jeffkub/esp32-energy-monitor/hardware/energy_monitor/energy_monitor.pdf

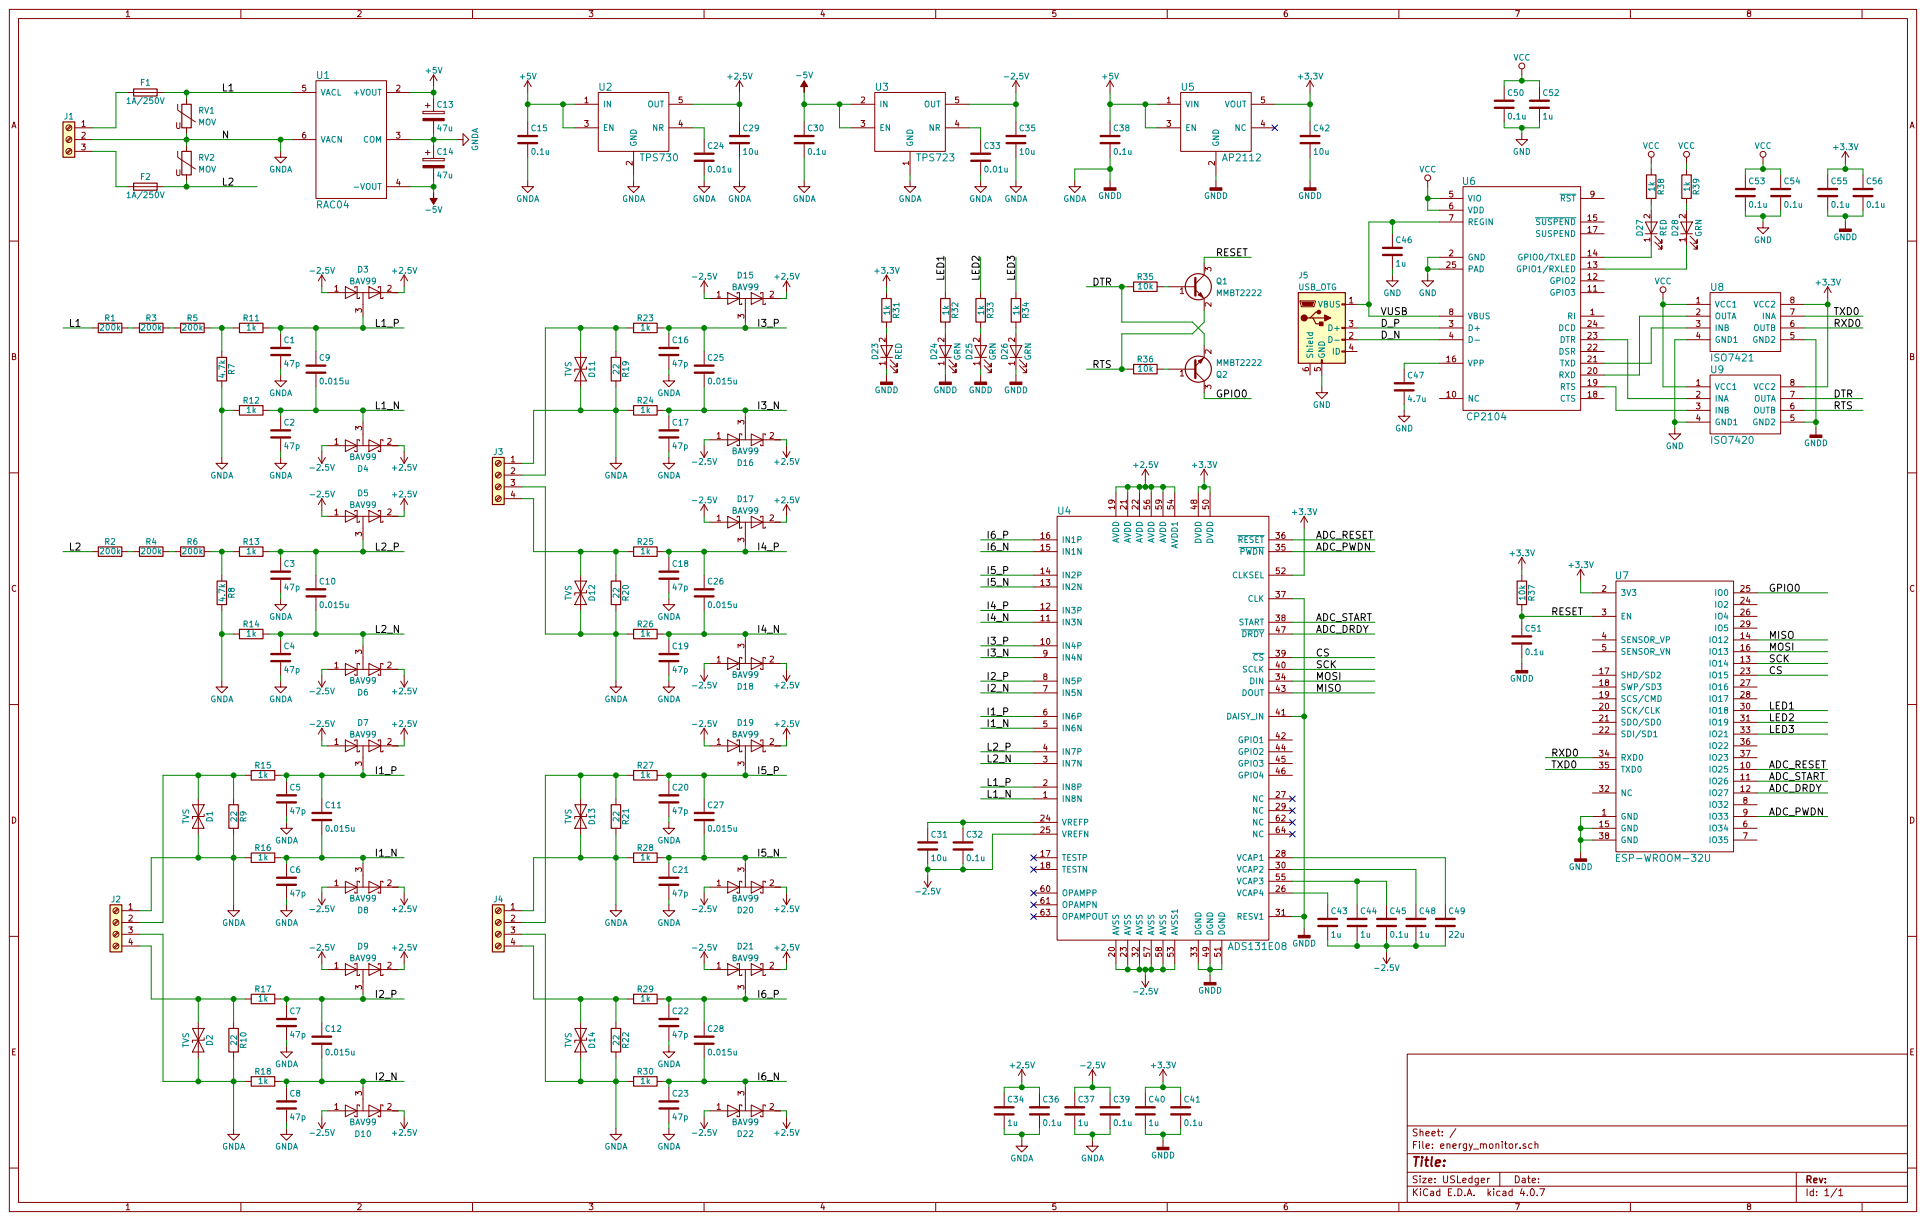
[picture p1: page 1]
