jeffkub/esp32-energy-monitor/hardware/energy_monitor/energy_monitor.kicad_pcb

## KiCad design hardware/energy_monitor/energy_monitor.kicad_pcb (2018-06-13)

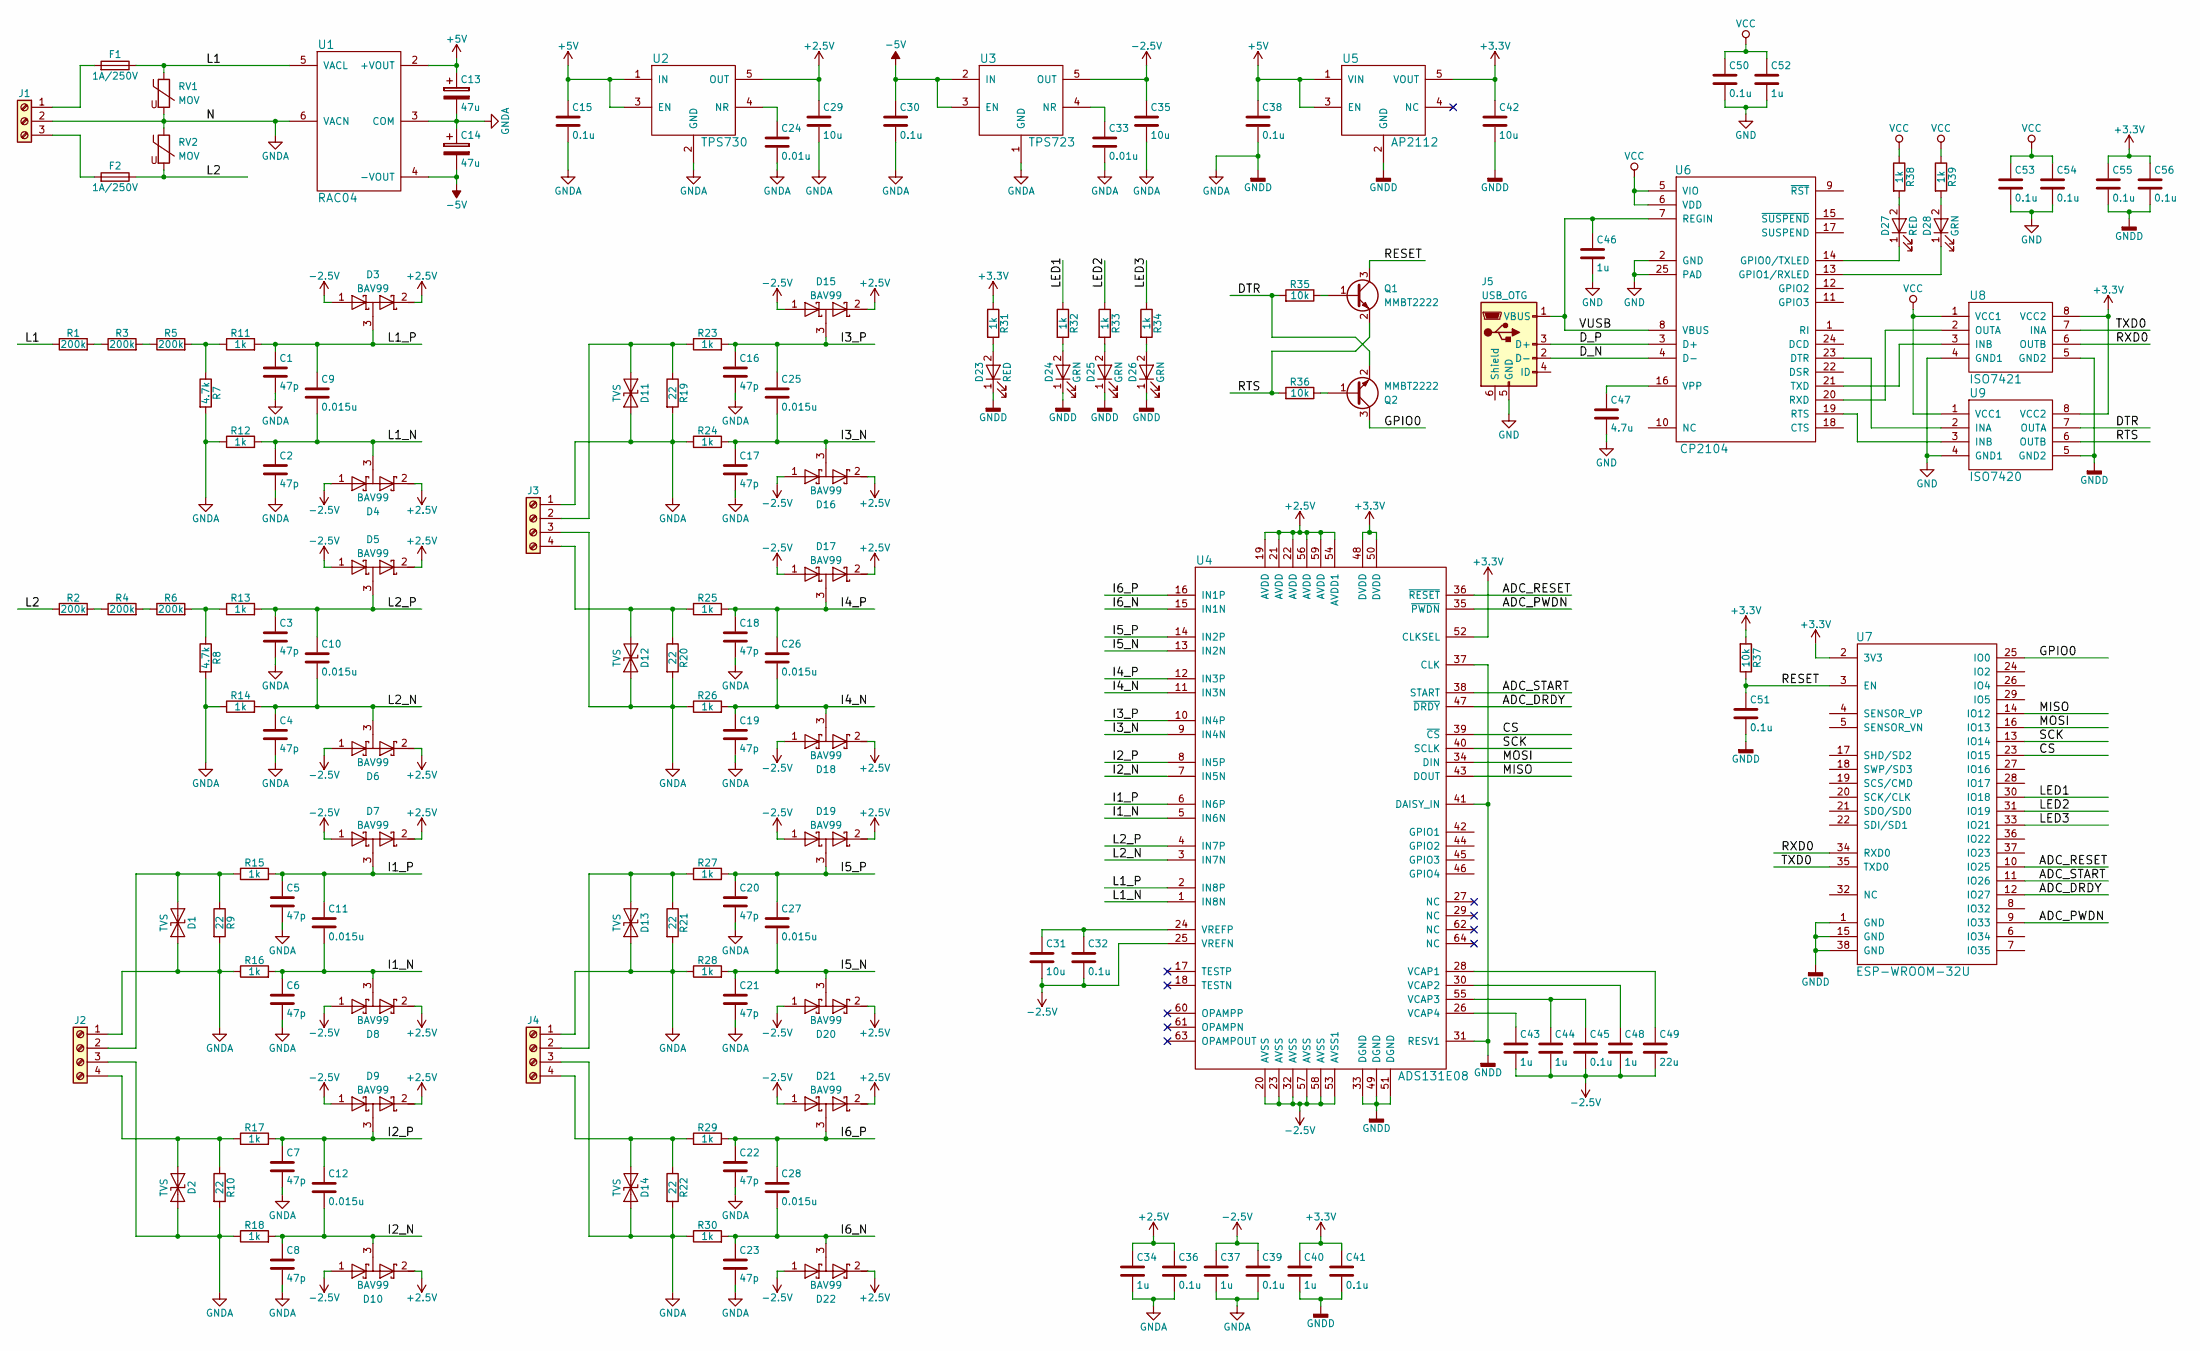
[picture p2: schematic energy_monitor.sch]

Parts:
C1, C2, C3, C4, C5, C6, C7, C8, C16, C17, C18, C19, C20, C21, C22, C23: 47p; C_0603; Part 490-4944-1-ND
C9, C10, C11, C12, C25, C26, C27, C28: 0.015u; C_0603; Part 490-6054-1-ND
C13, C14: 47u; CP_Elec_6.3x5.8; Part PCE3889CT-ND
C15, C30, C32, C36, C38, C39, C41, C45, C50, C51, C53, C54, C55, C56: 0.1u; C_0603; Part 490-9691-1-ND
C24, C33: 0.01u; C_0603; Part 490-1520-1-ND
C29, C31, C35, C42: 10u; C_0805; Part 490-5523-1-ND
C34, C37, C40, C43, C44, C46, C48, C52: 1u; C_0805; Part 490-1691-1-ND
C47: 4.7u; C_0805; Part 490-5422-1-ND
C49: 22u; C_1206; Part 490-8342-1-ND
D1, D2, D11, D12, D13, D14: TVS; D_SMA; Part SMAJ5.0CA-FDICT-ND
D3, D4, D5, D6, D7, D8, D9, D10, D15, D16, D17, D18, D19, D20, D21, D22: BAV99; SOT-23; Part BAV99-FDICT-ND
D23, D27: RED; D_0603; Part 160-1447-1-ND
D24, D25, D26, D28: GRN; D_0603; Part 160-1435-1-ND
F1, F2: 1A/250V; Fuse_Littelfuse-443; Part F2906CT-ND
J1: Screw_Terminal_01x03; TerminalBlock_03x5.08mm; Part 277-1264-ND
J2, J3, J4: Screw_Terminal_01x04; TerminalBlock_04x5.08mm; Part 277-1265-ND
J5: USB_OTG; UX60-MB-5ST; Part H2959CT-ND
Q1, Q2: MMBT2222; SOT-23; Part MMBT2222ALT3GOSCT-ND
R1, R2, R3, R4, R5, R6: 200k; R_1206; Part 311-200KFRCT-ND
R7, R8: 4.7k; R_1206; Part YAG2054CT-ND
R9, R10, R19, R20, R21, R22: 22; R_1206; Part YAG3847CT-ND
R11, R12, R13, R14, R15, R16, R17, R18, R23, R24, R25, R26, R27, R28, R29, R30, R31, R32, R33, R34, R38, R39: 1k; R_0603; Part 311-1.00KHRCT-ND
R35, R36, R37: 10k; R_0603; Part 311-10.0KHRCT-ND
RV1, RV2: MOV; RV_Disc_D12_W5_P7.5; Part P7207-ND
U1: RAC04; Part 945-2415-5-ND
U2: TPS730; SOT-23-5; Part 296-17578-1-ND
U3: TPS723; SOT-23-5; Part 296-39479-1-ND
U4: ADS131E08; TQFP-64_10x10mm_Pitch0.5mm; Part 296-43796-5-ND
U5: AP2112; SOT-23-5; Part AP2112K-3.3TRG1DICT-ND
U6: CP2104; QFN-24-1EP_4x4mm_Pitch0.5mm; Part 336-2008-5-ND
U7: ESP-WROOM-32U; ESP32-WROOM-32U
U8: ISO7421; SOIC-8_3.9x4.9mm_Pitch1.27mm; Part 296-38564-1-ND
U9: ISO7420; SOIC-8_3.9x4.9mm_Pitch1.27mm; Part 296-28742-1-ND

Connections:
+2.5V: C29.1, C34.1, C36.1, D3.2 (K), D4.2 (K), D5.2 (K), D6.2 (K), D7.2 (K), D8.2 (K), D9.2 (K), D10.2 (K), D15.2 (K), D16.2 (K), D17.2 (K), D18.2 (K), D19.2 (K), D20.2 (K), D21.2 (K), D22.2 (K), U2.5 (OUT), U4.19 (AVDD), U4.21 (AVDD), U4.22 (AVDD), U4.54 (AVDD1), U4.56 (AVDD), U4.59 (AVDD)
+3V3: C40.1, C41.1, C42.1, C55.1, C56.1, R31.1, R37.2, U4.48 (DVDD), U4.50 (DVDD), U4.52 (CLKSEL), U5.5 (VOUT), U7.2 (3V3), U8.8 (VCC2), U9.8 (VCC2)
+5V: C13.1, C15.1, C38.1, U1.2 (+VOUT), U2.1 (IN), U2.3 (EN), U5.1 (VIN), U5.3 (EN)
-2.5V: C31.2, C32.2, C35.1, C37.1, C39.1, C43.2, C44.2, C45.2, C48.2, C49.2, D3.1 (A), D4.1 (A), D5.1 (A), D6.1 (A), D7.1 (A), D8.1 (A), D9.1 (A), D10.1 (A), D15.1 (A), D16.1 (A), D17.1 (A), D18.1 (A), D19.1 (A), D20.1 (A), D21.1 (A), D22.1 (A), U3.5 (OUT), U4.20 (AVSS), U4.23 (AVSS), U4.25 (VREFN), U4.32 (AVSS), U4.53 (AVSS1), U4.57 (AVSS), U4.58 (AVSS)
-5V: C14.2, C30.1, U1.4 (-VOUT), U3.2 (IN), U3.3 (EN)
/ADC_DRDY: U4.47 (~DRDY), U7.12 (IO27)
/ADC_PWDN: U4.35 (~PWDN), U7.9 (IO33)
/ADC_RESET: U4.36 (~RESET), U7.10 (IO25)
/ADC_START: U4.38 (START), U7.11 (IO26)
/CS: U4.39 (~CS), U7.23 (IO15)
/DTR: Q2.2 (E), R35.2, U9.7 (OUTA)
/D_N: J5.2 (D-), U6.4 (D-)
/D_P: J5.3 (D+), U6.3 (D+)
/GPIO0: Q2.3 (C), U7.25 (IO0)
/I1_N: C6.1, C11.2, D8.3 (common), R16.2, U4.5 (IN6N)
/I1_P: C5.1, C11.1, D7.3 (common), R15.2, U4.6 (IN6P)
/I2_N: C8.1, C12.2, D10.3 (common), R18.2, U4.7 (IN5N)
/I2_P: C7.1, C12.1, D9.3 (common), R17.2, U4.8 (IN5P)
/I3_N: C17.1, C25.2, D16.3 (common), R24.2, U4.9 (IN4N)
/I3_P: C16.1, C25.1, D15.3 (common), R23.2, U4.10 (IN4P)
/I4_N: C19.1, C26.2, D18.3 (common), R26.2, U4.11 (IN3N)
/I4_P: C18.1, C26.1, D17.3 (common), R25.2, U4.12 (IN3P)
/I5_N: C21.1, C27.2, D20.3 (common), R28.2, U4.13 (IN2N)
/I5_P: C20.1, C27.1, D19.3 (common), R27.2, U4.14 (IN2P)
/I6_N: C23.1, C28.2, D22.3 (common), R30.2, U4.15 (IN1N)
/I6_P: C22.1, C28.1, D21.3 (common), R29.2, U4.16 (IN1P)
/L1: F1.1, R1.1, RV1.1, U1.5 (VACL)
/L1_N: C2.1, C9.2, D4.3 (common), R12.2, U4.1 (IN8N)
/L1_P: C1.1, C9.1, D3.3 (common), R11.2, U4.2 (IN8P)
/L2: F2.1, R2.1, RV2.2
/L2_N: C4.1, C10.2, D6.3 (common), R14.2, U4.3 (IN7N)
/L2_P: C3.1, C10.1, D5.3 (common), R13.2, U4.4 (IN7P)
/LED1: R32.1, U7.30 (IO18)
/LED2: R33.1, U7.31 (IO19)
/LED3: R34.1, U7.33 (IO21)
/MISO: U4.43 (DOUT), U7.14 (IO12)
/MOSI: U4.34 (DIN), U7.16 (IO13)
/RESET: C51.1, Q1.3 (C), R37.1, U7.3 (EN)
/RTS: Q1.2 (E), R36.2, U9.6 (OUTB)
/RXD0: U7.34 (RXD0), U8.6 (OUTB)
/SCK: U4.40 (SCLK), U7.13 (IO14)
/TXD0: U7.35 (TXD0), U8.7 (INA)
/VUSB: C46.1, J5.1 (VBUS), U6.7 (REGIN), U6.8 (VBUS)
GND: C46.2, C47.2, C50.2, C52.2, C53.2, C54.2, J5.5 (GND), U6.2 (GND), U6.25 (PAD), U8.4 (GND1), U9.4 (GND1)
GNDA: C1.2, C2.2, C3.2, C4.2, C5.2, C6.2, C7.2, C8.2, C13.2, C14.1, C15.2, C16.2, C17.2, C18.2, C19.2, C20.2, C21.2, C22.2, C23.2, C24.2, C29.2, C30.2, C33.2, C34.2, C35.2, C36.2, C37.2, C38.2, C39.2, C40.2, C41.2, C42.2, C51.2, C55.2, C56.2, D1.1 (A1), D2.1 (A1), D11.1 (A1), D12.1 (A1), D13.1 (A1), D14.1 (A1), D23.1 (K), D24.1 (K), D25.1 (K), D26.1 (K), J1.2, J2.1, J2.3, J3.1, J3.3, J4.1, J4.3, R7.2, R8.2, R9.2, R10.2, R12.1, R14.1, R16.1, R18.1, R19.2, R20.2, R21.2, R22.2, R24.1, R26.1, R28.1, R30.1, RV1.2, RV2.1, U1.3 (COM), U1.6 (VACN), U2.2 (GND), U3.1 (GND), U4.31 (RESV1), U4.33 (DGND), U4.37 (CLK), U4.41 (DAISY_IN), U4.49 (DGND), U4.51 (DGND), U5.2 (GND), U7.1 (GND), U7.15 (GND), U7.38 (GND), U8.5 (GND2), U9.5 (GND2)
unnamed: C24.1, U2.4 (NR)
unnamed: C31.1, C32.1, U4.24 (VREFP)
unnamed: C33.1, U3.4 (NR)
unnamed: C43.1, U4.26 (VCAP4)
unnamed: C44.1, C45.1, U4.55 (VCAP3)
unnamed: C47.1, U6.16 (VPP)
unnamed: C48.1, U4.30 (VCAP2)
unnamed: C49.1, U4.28 (VCAP1)
unnamed: D1.2 (A2), J2.2, R9.1, R15.1
unnamed: D2.2 (A2), J2.4, R10.1, R17.1
unnamed: D11.2 (A2), J3.2, R19.1, R23.1
unnamed: D12.2 (A2), J3.4, R20.1, R25.1
unnamed: D13.2 (A2), J4.2, R21.1, R27.1
unnamed: D14.2 (A2), J4.4, R22.1, R29.1
unnamed: D23.2 (A), R31.2
unnamed: D24.2 (A), R32.2
unnamed: D25.2 (A), R33.2
unnamed: D26.2 (A), R34.2
unnamed: D27.1 (K), U6.14 (GPIO0/TXLED)
unnamed: D27.2 (A), R38.2
unnamed: D28.1 (K), U6.13 (GPIO1/RXLED)
unnamed: D28.2 (A), R39.2
unnamed: F1.2, J1.1
unnamed: F2.2, J1.3
unnamed: Q1.1 (B), R35.1
unnamed: Q2.1 (B), R36.1
unnamed: R1.2, R3.1
unnamed: R2.2, R4.1
unnamed: R3.2, R5.1
unnamed: R4.2, R6.1
unnamed: R5.2, R7.1, R11.1
unnamed: R6.2, R8.1, R13.1
unnamed: U6.19 (RTS), U9.3 (INB)
unnamed: U6.20 (RXD), U8.2 (OUTA)
unnamed: U6.21 (TXD), U8.3 (INB)
unnamed: U6.23 (DTR), U9.2 (INA)
VCC: C50.1, C52.1, C53.1, C54.1, R38.1, R39.1, U6.5 (VIO), U6.6 (VDD), U8.1 (VCC1), U9.1 (VCC1)

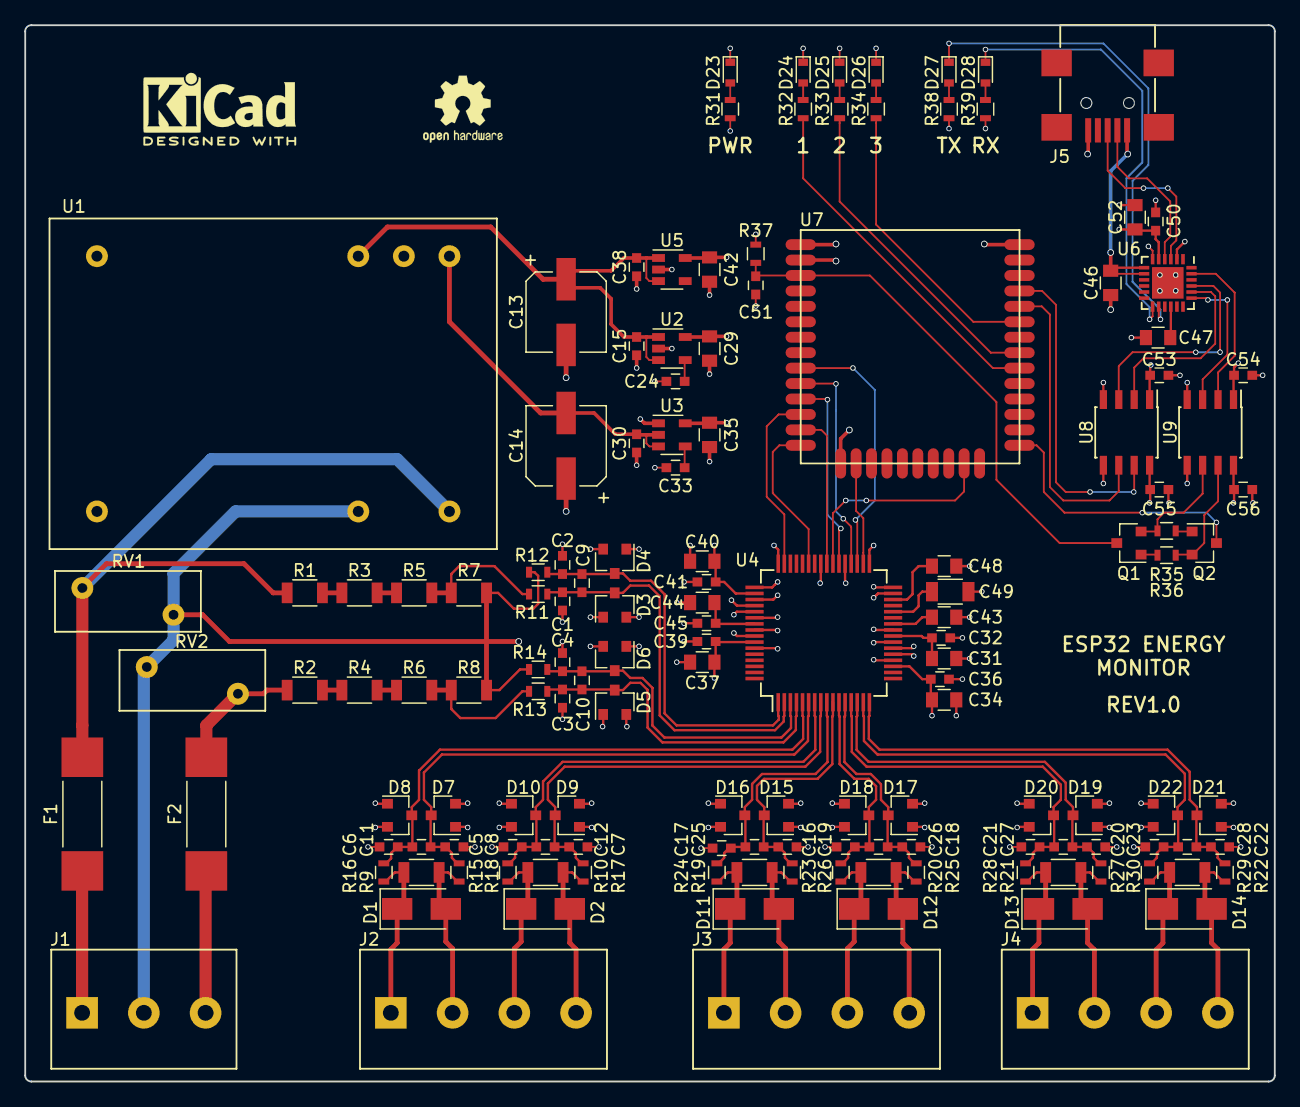
[picture p3: board energy_monitor.kicad_pcb from above]

Board: 4 copper layers, 102.8 x 86.9 mm, 143 parts (0 on the bottom side), 82 nets.
