jeffkub/esp32-energy-monitor/firmware/energy_monitor/src/main.cpp

#include <cassert>
#include <cstdlib>
#include <cstdio>

#include <freertos/FreeRTOS.h>
#include <freertos/task.h>

#include <driver/gpio.h>
#include <driver/periph_ctrl.h>
#include <driver/spi_master.h>
#include <soc/io_mux_reg.h>

#include "platform.h"
#include "ads131.h"
#include "daq.h"
#include "esp32_spi.h"

#define SAMPLE_RATE_HZ 4000
#define INTERVAL_LEN_S 5

static void platformInit(void);
static void blinkTask(void *arg);
static void daqTask(void *arg);

static ESP32SPI spi(&SPI2, ETS_SPI2_INTR_SOURCE);
static ADS131 adc(&spi, ADC_DRDY_PIN);
static DAQ daq(&adc, INTERVAL_LEN_S * SAMPLE_RATE_HZ);

static void platformInit(void)
{
    ESP_ERROR_CHECK(gpio_install_isr_service(ESP_INTR_FLAG_IRAM));

    /* GPIO configuration */
    gpio_pad_select_gpio(LED1_PIN);
    ESP_ERROR_CHECK(gpio_set_direction(LED1_PIN, GPIO_MODE_OUTPUT));
    ESP_ERROR_CHECK(gpio_set_level(LED1_PIN, 0));

    gpio_pad_select_gpio(LED2_PIN);
    ESP_ERROR_CHECK(gpio_set_direction(LED2_PIN, GPIO_MODE_OUTPUT));
    ESP_ERROR_CHECK(gpio_set_level(LED2_PIN, 0));

    gpio_pad_select_gpio(LED3_PIN);
    ESP_ERROR_CHECK(gpio_set_direction(LED3_PIN, GPIO_MODE_OUTPUT));
    ESP_ERROR_CHECK(gpio_set_level(LED3_PIN, 0));

    gpio_pad_select_gpio(ADC_RESET_PIN);
    ESP_ERROR_CHECK(gpio_set_direction(ADC_RESET_PIN, GPIO_MODE_OUTPUT));
    ESP_ERROR_CHECK(gpio_set_level(ADC_RESET_PIN, 1));

    gpio_pad_select_gpio(ADC_PWDN_PIN);
    ESP_ERROR_CHECK(gpio_set_direction(ADC_PWDN_PIN, GPIO_MODE_OUTPUT));
    ESP_ERROR_CHECK(gpio_set_level(ADC_PWDN_PIN, 1));

    gpio_pad_select_gpio(ADC_START_PIN);
    ESP_ERROR_CHECK(gpio_set_direction(ADC_START_PIN, GPIO_MODE_OUTPUT));
    ESP_ERROR_CHECK(gpio_set_level(ADC_START_PIN, 0));

    gpio_pad_select_gpio(ADC_DRDY_PIN);
    ESP_ERROR_CHECK(gpio_set_direction(ADC_DRDY_PIN, GPIO_MODE_INPUT));

    gpio_pad_select_gpio(DEBUG1_PIN);
    ESP_ERROR_CHECK(gpio_set_direction(DEBUG1_PIN, GPIO_MODE_OUTPUT));
    ESP_ERROR_CHECK(gpio_set_level(DEBUG1_PIN, 0));

    gpio_pad_select_gpio(DEBUG2_PIN);
    ESP_ERROR_CHECK(gpio_set_direction(DEBUG2_PIN, GPIO_MODE_OUTPUT));
    ESP_ERROR_CHECK(gpio_set_level(DEBUG2_PIN, 0));

    /* SPI configuration */
    periph_module_enable(PERIPH_HSPI_MODULE);

    PIN_FUNC_SELECT(GPIO_PIN_MUX_REG[CS_PIN], FUNC_MTDO_HSPICS0);
    PIN_FUNC_SELECT(GPIO_PIN_MUX_REG[SCK_PIN], FUNC_MTMS_HSPICLK);
    PIN_FUNC_SELECT(GPIO_PIN_MUX_REG[MOSI_PIN], FUNC_MTCK_HSPID);
    PIN_FUNC_SELECT(GPIO_PIN_MUX_REG[MISO_PIN], FUNC_MTDI_HSPIQ);

    spi.init();

    /* Driver initialization */
    adc.init();
    adc.setVRef(ADS131::VRef_Internal_4V);
    adc.setDataRate(ADS131::DataRate_24bit_4ksps);
}

static void blinkTask(void *arg)
{
    while(1)
    {
        gpio_set_level(LED1_PIN, 1);
        vTaskDelay(250 / portTICK_PERIOD_MS);

        gpio_set_level(LED1_PIN, 0);
        vTaskDelay(250 / portTICK_PERIOD_MS);
    }
}

static void daqTask(void *arg)
{
    daq.start();

    while(1)
    {
        daq.wait();

        printf("V1=%7.3f, V2=%7.3f\n", daq.getV1(), daq.getV2());
    }
}

extern "C" void app_main()
{
    printf("Program start\n");

    platformInit();

    assert(xTaskCreate(&blinkTask, "blinkTask", configMINIMAL_STACK_SIZE, NULL, 1, NULL) == pdPASS);
    assert(xTaskCreate(&daqTask, "daqTask", 4096, NULL, configMAX_PRIORITIES - 2, NULL) == pdPASS);
}
