jeffkub/esp32-energy-monitor/(commit log)

2018-06-02 Added kicad-libs submodule
2018-06-02 Created KiCad project
    [energy_monitor.kicad_pcb, energy_monitor.sch]
2018-06-03 Working on schematic
    [energy_monitor.sch]
2018-06-03 Added footprints and part numbers for signal conditioning circuits
    [energy_monitor.sch]
2018-06-05 Working on BOM and assigning footprints
    [energy_monitor.sch]
2018-06-06 Working on footprints
    [energy_monitor.sch]
2018-06-07 Exported netlist. Working on layout
    [energy_monitor.kicad_pcb]
2018-06-07 Working on layout
    [energy_monitor.kicad_pcb, energy_monitor.sch]
2018-06-08 Configured design rules
    [energy_monitor.kicad_pcb]
2018-06-09 Working on layout. Removed 0.1u caps on 5V output
    [energy_monitor.kicad_pcb, energy_monitor.sch]
2018-06-09 Switched 3.5mm jacks to terminal blocks
    [energy_monitor.kicad_pcb, energy_monitor.sch]
2018-06-09 Added digital isolator to USB UART circuit
    [energy_monitor.kicad_pcb, energy_monitor.sch]
2018-06-11 Finished routing board
    [energy_monitor.kicad_pcb, energy_monitor.sch]
2018-06-11 Fixed silkscreen layers
    [energy_monitor.kicad_pcb]
2018-06-12 Added 2 more LEDs. Added labels to LEDs. Added board rev #
    [energy_monitor.kicad_pcb, energy_monitor.sch]
2018-06-12 Rounded the corners
    [energy_monitor.kicad_pcb]
2018-06-13 Minor PCB tweaks and created gerbers
    [energy_monitor.kicad_pcb]
2018-06-17 Created class for adc driver
2018-06-17 working on adc driver
2018-07-13 Changed to SPI mode 1, able to read ID register
2018-07-14 Added task to test ADC driver
2018-07-21 ADC read is now working
2018-07-22 Fixed IRQ/semaphore issues with ADC driver
    [ads131.cpp, main.cpp]
2018-07-23 Moved ADC test code into DAQ class
2018-07-24 Created SPI driver class
2018-07-24 Working on spi driver
2018-07-24 Cleaning up SPI driver code
2018-07-25 Added function to set SPI mode
2018-07-29 Optimizing SPI driver
2018-08-01 Modified AD131 driver to use ESP32 SPI driver
2018-08-02 ADS131 driver now working with new SPI driver
2018-08-02 Added debug pin GPIO config
2018-08-12 Added task to print DAQ values periodically
2018-08-13 Added scaling factor for voltage/ current inputs
